dmejiaho/RISC-V_2_D/(commit log)

2026-10-25 README de la RAM: antes, después y qué se ve en GTKWave
2026-10-25 README de la RAM: capturas de GTKWave del error de los 31 bits
